elcoco/eeg/README.md

EEG
===

This project is about creating an EEG device based  
on the ADS1299 chip and a raspberrypi 2.  
In this repository you'll find cad files for making  
the PCB and also the software.  
It is a work in progress and is nowhere near finished.
