elcoco/eeg/docs/7077.BandwidthSlide.pptx

## Signals from Body

- EMG (Electromyography) – electrical activity by skeletal muscles
- ECG (Electrocardiography) – electrical activity of the heart
- EEG (Electroencephalography) – electrical activity of the brain
- Pace signal – Signal from Pacemaker
- Respiration – study of impedance created from inhale/exhale

## Bandwidth of interest

~10mV

EMG Signal

ECG Signal

Including Gamma

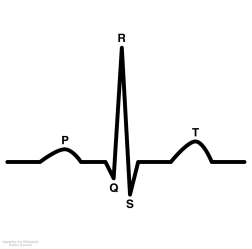
[picture p1: figure]

~5mV

Max Signal Amplitude

~5mV

Pacemaker Signal

~1mV

EEG Signal

Respiration 0 to 0.4Hz

*Amplitude dependent on external current source

20Hz

60Hz

150Hz

500Hz

10 KHz

0.05Hz

50Hz

120Hz

*Frequency ranges are estimates. Actual frequency range will depend on specific application

Frequency
