elcoco/eeg/docs/schematic from blog.png

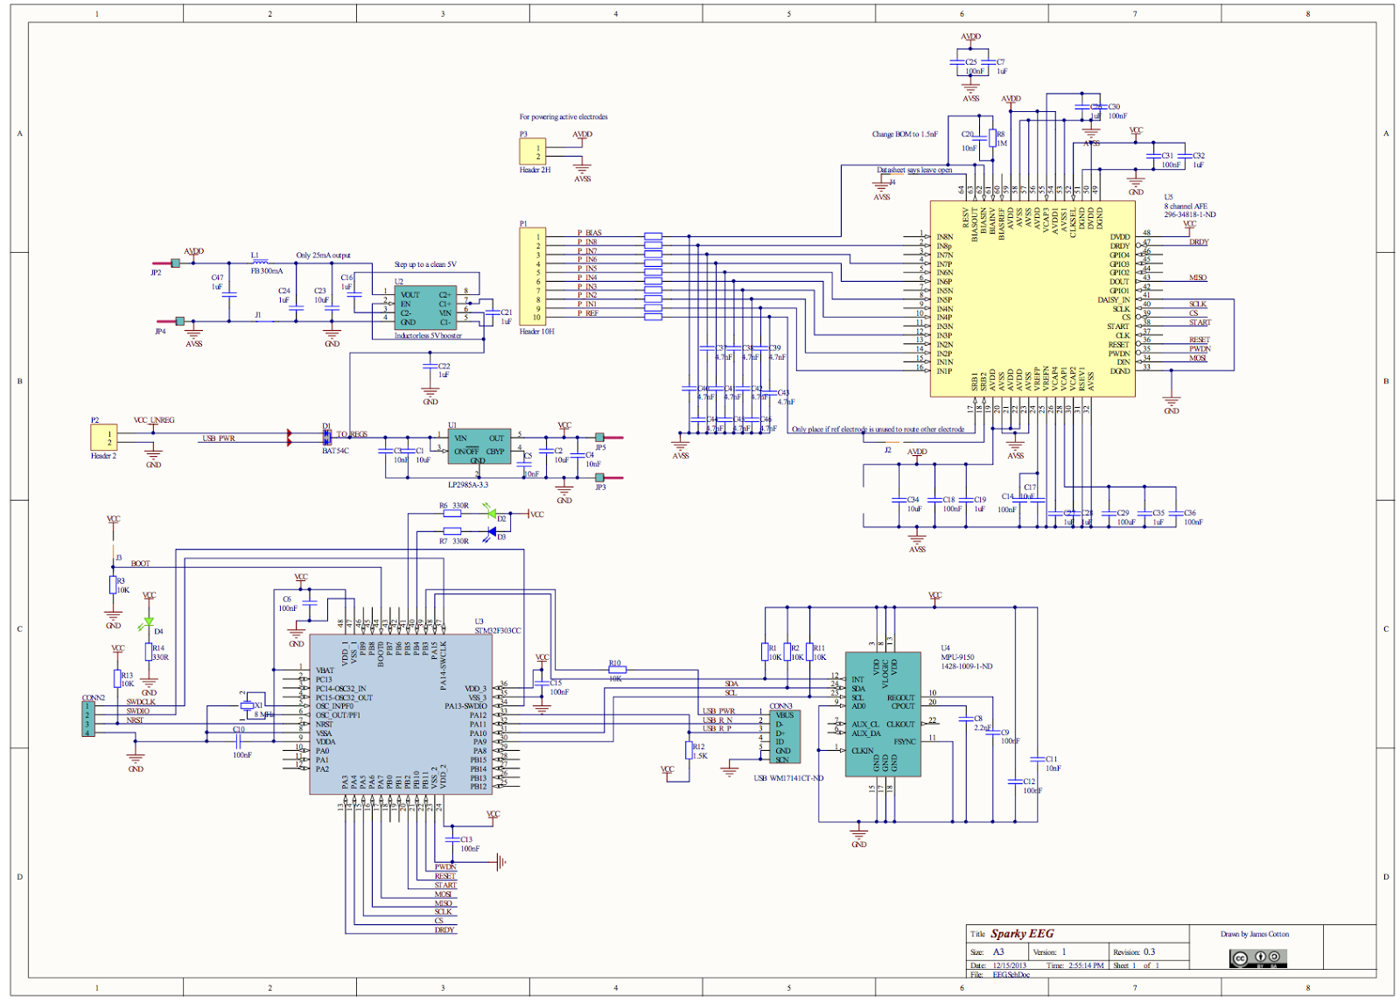
docs/schematic from blog.png
