elcoco/eeg/docs/ADS family comparison.xls

Part Number | Description | Status | # Input Channels | Analog Voltage AV/DD(Min)(V) | Analog Voltage AV/DD(Max)(V) | Architecture | Digital Supply(Max)(V) | Digital Supply(Min)(V) | Gain Drift(Typ)(ppm/degC) | Gain Error(Typ)(%) | IAVDD Supply Current(Typ)(mA) | IDVDD Supply Current(Typ)(mA) | INL(Typ)(ppm) | Input-referred Noise(Typ)(uVpp) | Integrated Features | Interface | Offset Error(Typ)(uV) | Offset error drift(Typ)(uV/C) | PGA Gain(Typ)(V/V) | Power Consumption(Typ)(mW) | Power/Channel(Typ)(mW) | Reference Mode | Rating | Operating Temperature Range(C) | Package Group
ADS1293 (http://www.ti.com/product/ads1293) | Complete Low Power Integrated Analog Front End for ECG Applications | ACTIVE | 3 | 2.7 | 5.5 | Delta-Sigma | 3.6 | 1.65 | 10 | 1.4 | 0.205 | 0.0006 | 2 | 7 | Oscillator | Serial SPI | 16 | 0.01 | 3.5 | 0.9 | 0.3 | Int | Catalog | -20 to 85 | WQFN
ADS1299 (http://www.ti.com/product/ads1299) | Low-Noise, 8-Channel, 24-Bit Analog Front-End for Biopotential Measurements | ACTIVE | 8 | 4.75 | 5.25 | Delta-Sigma | 3.6 | 1.8 |  |  |  |  |  | 1 | Daisy-Chainable, GPIOs, Oscillator, PGA | Serial SPI |  |  | 1, 2, 4, 6, 8, 12, 24 | 41 | 5.125 | Int, Ext | Catalog | -40 to 85 | TQFP
ADS1292R (http://www.ti.com/product/ads1292r) | 3-Channel, 24-Bit Analog-To-Digital Converter w/Integrated Respiration Impedance and ECG Front End | ACTIVE | 3 | 2.7 | 5.25 | Delta-Sigma | 3.6 | 1.7 |  |  |  |  | 2 | 8 | Daisy-Chainable, GPIOs, Oscillator, PGA | Serial SPI |  |  | 1, 2, 3, 4, 6, 8, 12 | 0.7 | 0.35 | Int, Ext | Catalog | -40 to 85 | TQFP, VQFN
ADS1191 (http://www.ti.com/product/ads1191) | Complete Low Power Integrated Analog Front End for ECG Applications | ACTIVE | 1 | 2.7 | 5.25 | Delta-Sigma | 3.6 | 1.7 |  |  |  |  | 15 | 24 | Daisy-Chainable, GPIOs, Oscillator, PGA | Serial SPI |  |  | 1, 2, 3, 4, 6, 8, 12 | 0.335 | 0.335 | Int, Ext | Catalog | -40 to 85 | TQFP, VQFN
ADS1192 (http://www.ti.com/product/ads1192) | Complete Low Power Integrated Analog Front End for ECG Applications | ACTIVE | 2 | 2.7 | 5.25 | Delta-Sigma | 3.6 | 1.7 |  |  |  |  | 15 | 24 | Daisy-Chainable, GPIOs, Oscillator, PGA | Serial SPI |  |  | 1, 2, 3, 4, 6, 8, 12 | 0.67 | 0.335 | Int, Ext | Catalog | -40 to 85 | TQFP, VQFN
ADS1291 (http://www.ti.com/product/ads1291) | Complete Low Power Integrated Analog Front End for ECG Applications | ACTIVE | 1 | 2.7 | 5.25 | Delta-Sigma | 3.6 | 1.7 |  |  |  |  | 2 | 8 | Daisy-Chainable, GPIOs, Oscillator, PGA | Serial SPI |  |  | 1, 2, 3, 4, 6, 8, 12 | 0.35 | 0.35 | Int, Ext | Catalog | -40 to 85 | TQFP, VQFN
ADS1292 (http://www.ti.com/product/ads1292) | Complete Low Power Integrated Analog Front End for ECG Applications | ACTIVE | 3 | 2.7 | 5.25 | Delta-Sigma | 3.6 | 1.7 |  |  |  |  | 2 | 8 | Daisy-Chainable, GPIOs, Oscillator, PGA | Serial SPI |  |  | 1, 2, 3, 4, 6, 8, 12 | 0.7 | 0.35 | Int, Ext | Catalog | -40 to 85 | TQFP, VQFN
ADS1294R (http://www.ti.com/product/ads1294r) | 4-Channel, 24-Bit Analog-To-Digital Converter w/Integrated Respiration Impedance and ECG Front End | ACTIVE | 4 | 2.7 | 5.25 | Delta-Sigma | 3.6 | 1.65 | 5 | 0.2 | 2.75 | 0.5 | 8 | 3 | Daisy-Chainable, GPIOs, Oscillator, PGA | Serial SPI | 500 | 5 | 1, 2, 3, 4, 6, 8, 12 | 4.1 | 1.025 | Int, Ext | Catalog | -40 to 85 | NFBGA
ADS1296R (http://www.ti.com/product/ads1296r) | 6-Channel, 24-Bit Analog-To-Digital Converter w/Integrated Respiration Impedance and ECG Front End | ACTIVE | 6 | 2.7 | 5.25 | Delta-Sigma | 3.6 | 1.65 | 5 | 0.2 | 2.75 | 0.5 | 8 | 3 | Daisy-Chainable, GPIOs, Oscillator, PGA | Serial SPI | 500 | 2 | 1, 2, 3, 4, 6, 8, 12 | 5.3 | 0.88 | Int, Ext | Catalog | -40 to 85 | NFBGA
ADS1298R (http://www.ti.com/product/ads1298r) | 8-Channel, 24-Bit Analog-To-Digital Converter w/Integrated Respiration Impedance and ECG Front End | ACTIVE | 8 | 2.7 | 5.25 | Delta-Sigma | 3.6 | 1.65 | 5 | 0.2 | 2.75 | 0.5 | 8 | 3 | Daisy-Chainable, GPIOs, Oscillator, PGA | Serial SPI | 500 | 2 | 1, 2, 3, 4, 6, 8, 12 | 6 | 0.75 | Int, Ext | Catalog | -40 to 85 | NFBGA
ADS1194 (http://www.ti.com/product/ads1194) | Low-Power, 4-Channel, 16-Bit Analog Front-End for ECG | ACTIVE | 4 | 2.7 | 5.25 | Delta-Sigma | 3.6 | 1.65 | 5 | 0.2 | 0.5 | 0.5 | 15 | 12.2 | Daisy-Chainable, GPIOs, Oscillator, PGA | Serial SPI | 500 | 2 | 1, 2, 3, 4, 6, 8, 12 | 3 | 0.75 | Int, Ext | Catalog | 0 to 70 | NFBGA, TQFP
ADS1196 (http://www.ti.com/product/ads1196) | Low-Power, 6-Channel, 16-Bit Analog Front-End for ECG | ACTIVE | 6 | 2.7 | 5.25 | Delta-Sigma | 3.6 | 1.65 | 5 | 0.2 | 0.7 | 0.5 | 15 | 12.2 | Daisy-Chainable, GPIOs, Oscillator, PGA | Serial SPI | 500 | 2 | 1, 2, 3, 4, 6, 8, 12 | 3.6 | 0.6 | Int, Ext | Catalog | 0 to 70 | NFBGA, TQFP
ADS1294 (http://www.ti.com/product/ads1294) | 4-Channel, 24-Bit Analog-To-Digital Converter With Integrated ECG Front End | ACTIVE | 4 | 2.7 | 5.25 | Delta-Sigma | 3.6 | 1.65 | 5 | 0.2 | 2.75 | 0.5 | 8 | 3 | Daisy-Chainable, GPIOs, Oscillator, PGA | Serial SPI | 500 | 2 | 1, 2, 3, 4, 6, 8, 12 | 3 | 0.75 | Int, Ext | Catalog | -40 to 85, 0 to 70 | NFBGA, TQFP
ADS1296 (http://www.ti.com/product/ads1296) | 6-Channel, 24-Bit Analog-To-Digital Converter With Integrated ECG Front End | ACTIVE | 6 | 2.7 | 5.25 | Delta-Sigma | 3.6 | 1.65 | 5 | 0.2 | 2.75 | 0.5 | 8 | 3 | Daisy-Chainable, GPIOs, Oscillator, PGA | Serial SPI | 500 | 2 | 1, 2, 3, 4, 6, 8, 12 | 5.3 | 0.88 | Int, Ext | Catalog | -40 to 85, 0 to 70 | NFBGA, TQFP
ADS1198 (http://www.ti.com/product/ads1198) | Low-Noise, 8 Channel, 16 Bit Analog Front End for ECG/EEG Measurements | ACTIVE | 8 | 2.7 | 5.25 | Delta-Sigma | 3.6 | 1.65 | 5 | 0.2 | 1.3 | 0.5 | 15 | 12.2 | Daisy-Chainable, GPIOs, Oscillator, PGA | Serial SPI | 500 | 2 | 1, 2, 3, 4, 6, 8, 12 | 4.3 | 0.54 | Int, Ext | Catalog | 0 to 70 | NFBGA, TQFP
ADS1298 (http://www.ti.com/product/ads1298) | 8-Channel, 24-Bit Analog-To-Digital Converter With Integrated ECG Front End | ACTIVE | 8 | 2.7 | 5.25 | Delta-Sigma | 3.6 | 1.65 | 5 | 0.2 | 2.75 | 0.5 | 8 | 3 | Daisy-Chainable, GPIOs, Oscillator, PGA | Serial SPI | 500 | 2 | 1, 2, 3, 4, 6, 8, 12 | 6 | 0.75 | Int, Ext | Catalog | -40 to 85, 0 to 70 | NFBGA, TQFP
