elcoco/eeg/(list of files, drawings)

Other design files:
docs/eeg_main_board.fzz
docs/OpenBCI 8bit.pcb
docs/OpenBCI 32bit.pcb
