elcoco/eeg/pcb/kicad/eeg-pcb.kicad_pcb

## KiCad design pcb/kicad/eeg-pcb.kicad_pcb (2016-02-10)

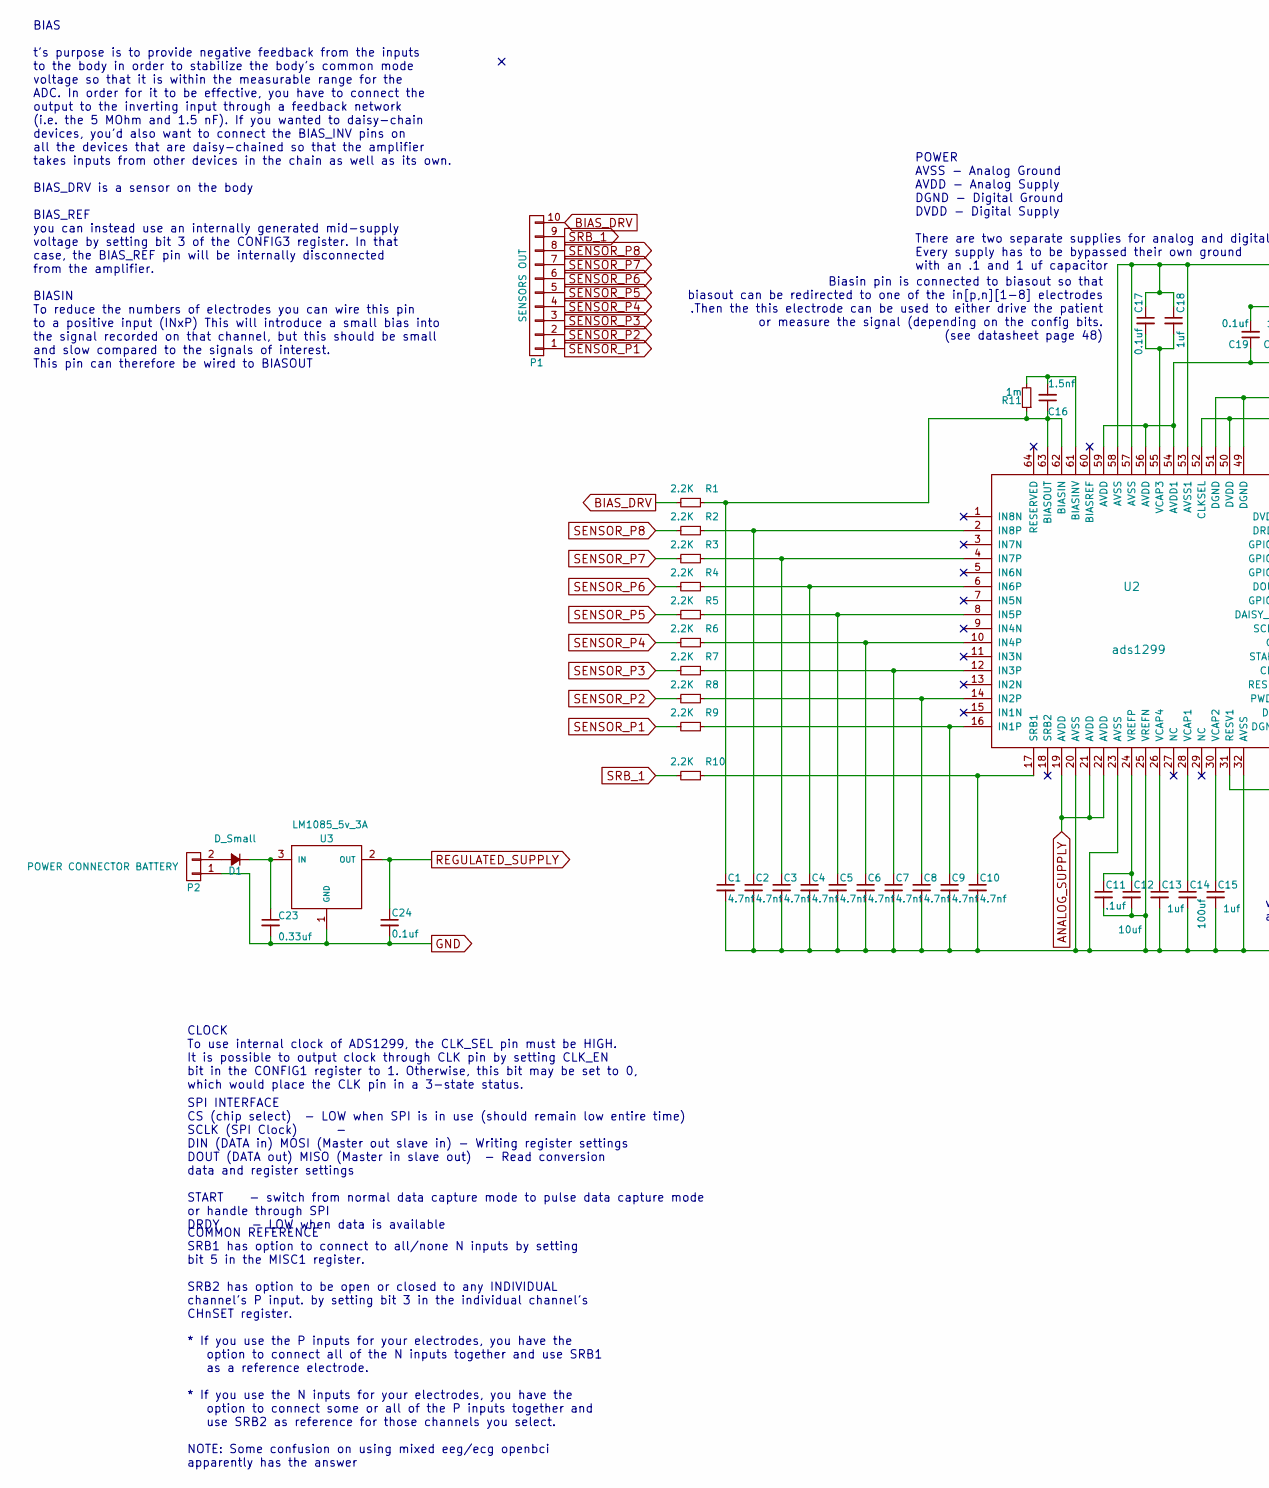
[picture p3: schematic eeg-pcb.sch, EEG Schema using ads1299, part in row 1, column 1]

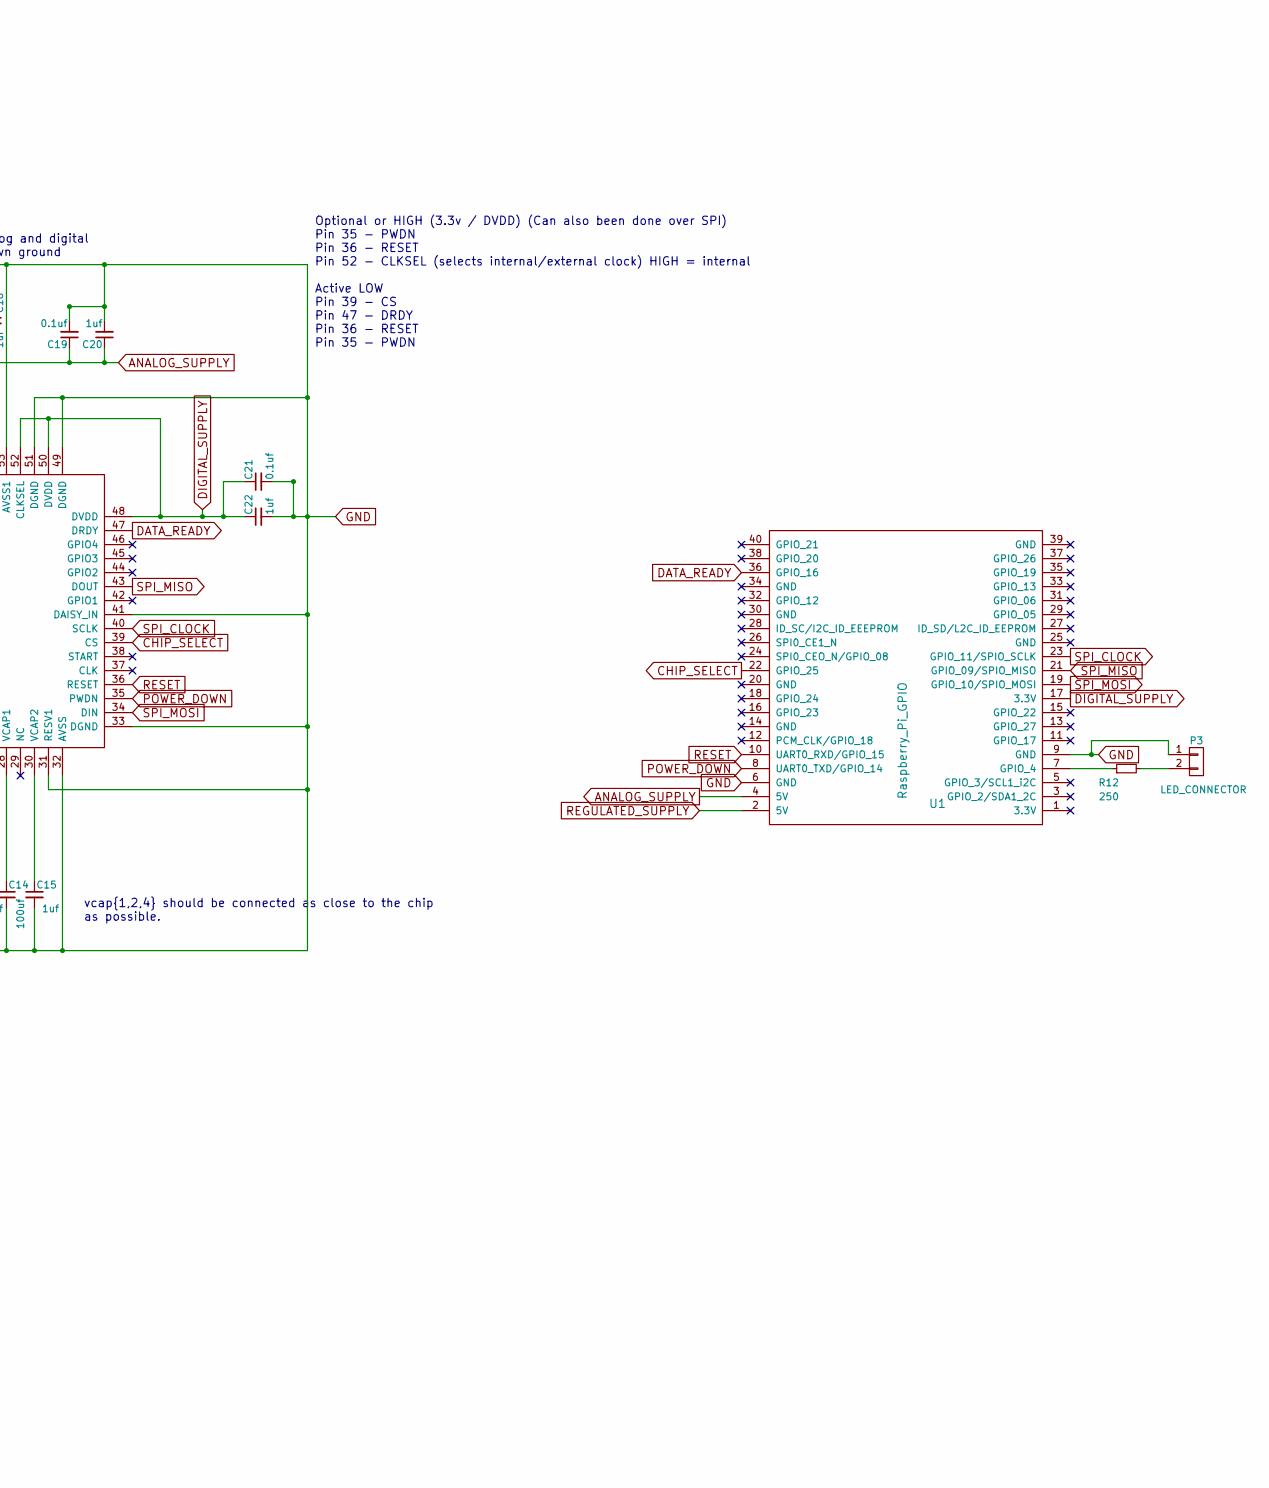
[picture p4: schematic eeg-pcb.sch, EEG Schema using ads1299, part in row 1, column 2]

Parts:
C1, C2, C3, C4, C5, C6, C7, C8, C9, C10: 4.7nf; C_0603_HandSoldering
C11: .1uf; C_0603_HandSoldering
C12: 10uf; C_0603_HandSoldering
C13, C15, C18, C20, C22: 1uf; C_0603_HandSoldering
C14: 100uf; C_0603_HandSoldering
C16: 1.5nf; C_0603_HandSoldering
C17, C19, C21, C24: 0.1uf; C_0603_HandSoldering
C23: 0.33uf; C_0603_HandSoldering
D1: D_Small; 1n1008
P1: SENSORS OUT; Pin_Header_Straight_1x10
P2: POWER CONNECTOR BATTERY; Pin_Header_Straight_1x02
P3: LED_CONNECTOR; Pin_Header_Straight_1x02
R1, R2, R3, R4, R5, R6, R7, R8, R9, R10: 2.2K; R_0603_HandSoldering
R11: 1m; R_0603_HandSoldering
R12: 250; R_0603_HandSoldering
U1: Raspberry_Pi_GPIO; Pin_Header_Straight_2x20
U2: ads1299
U3: LM1085_5v_3A; LM1085

Connections:
ANALOG_SUPPLY: C19.1, C20.1, U1.4 (5V), U2.19 (AVDD), U2.21 (AVDD), U2.22 (AVDD), U2.54 (AVDD1), U2.56 (AVDD), U2.59 (AVDD)
BIAS_DRV: P1.10, R1.2
CHIP_SELECT: U1.22 (GPIO_25), U2.39 (CS)
DATA_READY: U1.36 (GPIO_16), U2.47 (DRDY)
DIGITAL_SUPPLY: C21.1, C22.1, U1.17 (3.3V), U2.48 (DVDD), U2.50 (DVDD), U2.52 (CLKSEL)
GND: C1.2, C2.2, C3.2, C4.2, C5.2, C6.2, C7.2, C8.2, C9.2, C10.2, C11.2, C12.2, C13.2, C14.2, C15.2, C17.1, C18.1, C19.2, C20.2, C21.2, C22.2, C23.2, C24.2, P2.1, P3.1, U1.6 (GND), U1.9 (GND), U2.20 (AVSS), U2.23 (AVSS), U2.25 (VREFN), U2.31 (RESV1), U2.32 (AVSS), U2.33 (DGND), U2.41 (DAISY_IN), U2.49 (DGND), U2.51 (DGND), U2.53 (AVSS1), U2.57 (AVSS), U2.58 (AVSS), U3.1 (GND)
unnamed: C1.1, C16.1, R1.1, R11.1, U2.62 (BIASIN), U2.63 (BIASOUT)
unnamed: C2.1, R2.1, U2.2 (IN8P)
unnamed: C3.1, R3.1, U2.4 (IN7P)
unnamed: C4.1, R4.1, U2.6 (IN6P)
unnamed: C5.1, R5.1, U2.8 (IN5P)
unnamed: C6.1, R6.1, U2.10 (IN4P)
unnamed: C7.1, R7.1, U2.12 (IN3P)
unnamed: C8.1, R8.1, U2.14 (IN2P)
unnamed: C9.1, R9.1, U2.16 (IN1P)
unnamed: C10.1, R10.1, U2.17 (SRB1)
unnamed: C11.1, C12.1, U2.24 (VREFP)
unnamed: C13.1, U2.26 (VCAP4)
unnamed: C14.1, U2.28 (VCAP1)
unnamed: C15.1, U2.30 (VCAP2)
unnamed: C16.2, R11.2, U2.61 (BIASINV)
unnamed: C17.2, C18.2, U2.55 (VCAP3)
unnamed: C23.1, D1.1 (K), U3.3 (IN)
unnamed: D1.2 (A), P2.2
unnamed: P3.2, R12.2
unnamed: R12.1, U1.7 (GPIO_4)
POWER_DOWN: U1.8 (UART0_TXD/GPIO_14), U2.35 (PWDN)
REGULATED_SUPPLY: C24.1, U1.2 (5V), U3.2 (OUT)
RESET: U1.10 (UART0_RXD/GPIO_15), U2.36 (RESET)
SENSOR_P1: P1.1, R9.2
SENSOR_P2: P1.2, R8.2
SENSOR_P3: P1.3, R7.2
SENSOR_P4: P1.4, R6.2
SENSOR_P5: P1.5, R5.2
SENSOR_P6: P1.6, R4.2
SENSOR_P7: P1.7, R3.2
SENSOR_P8: P1.8, R2.2
SPI_CLOCK: U1.23 (GPIO_11/SPIO_SCLK), U2.40 (SCLK)
SPI_MISO: U1.21 (GPIO_09/SPIO_MISO), U2.43 (DOUT)
SPI_MOSI: U1.19 (GPIO_10/SPIO_MOSI), U2.34 (DIN)
SRB_1: P1.9, R10.2

Notes on the sheet:
Optional or HIGH (3.3v / DVDD) (Can also been done over SPI) Pin 35 - PWDN Pin 36 - RESET Pin 52 - CLKSEL (selects internal/external clock) HIGH = internal Active LOW Pin 39 - CS Pin 47 - DRDY Pin 36 - RESET Pin 35 - PWDN
BIAS t's purpose is to provide negative feedback from the inputs to the body in order to stabilize the body's common mode voltage so that it is within the measurable range for the ADC. In order for it to be effective, you have to connect the output to the inverting input through a feedback network 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
COMMON REFERENCE SRB1 has option to connect to all/none N inputs by setting bit 5 in the MISC1 register. SRB2 has option to be open or closed to any INDIVIDUAL channel's P input. by setting bit 3 in the individual channel's CHnSET register. * If you use the P inputs for your electrodes, you have th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
SPI INTERFACE CS (chip select) - LOW when SPI is in use (should remain low entire time) SCLK (SPI Clock) - DIN (DATA in) MOSI (Master out slave in) - Writing register settings DOUT (DATA out) MISO (Master in slave out) - Read conversion data and register settings START - switch from normal data cap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
POWER AVSS - Analog Ground AVDD - Analog Supply DGND - Digital Ground DVDD - Digital Supply There are two separate supplies for analog and digital Every supply has to be bypassed their own ground with an .1 and 1 uf capacitor
CLOCK To use internal clock of ADS1299, the CLK_SEL pin must be HIGH. It is possible to output clock through CLK pin by setting CLK_EN bit in the CONFIG1 register to 1. Otherwise, this bit may be set to 0, which would place the CLK pin in a 3-state status.
vcap{1,2,4} should be connected as close to the chip as possible.
Biasin pin is connected to biasout so that biasout can be redirected to one of the in[p,n][1-8] electrodes .Then the this electrode can be used to either drive the patient or measure the signal (depending on the config bits. (see datasheet page 48)

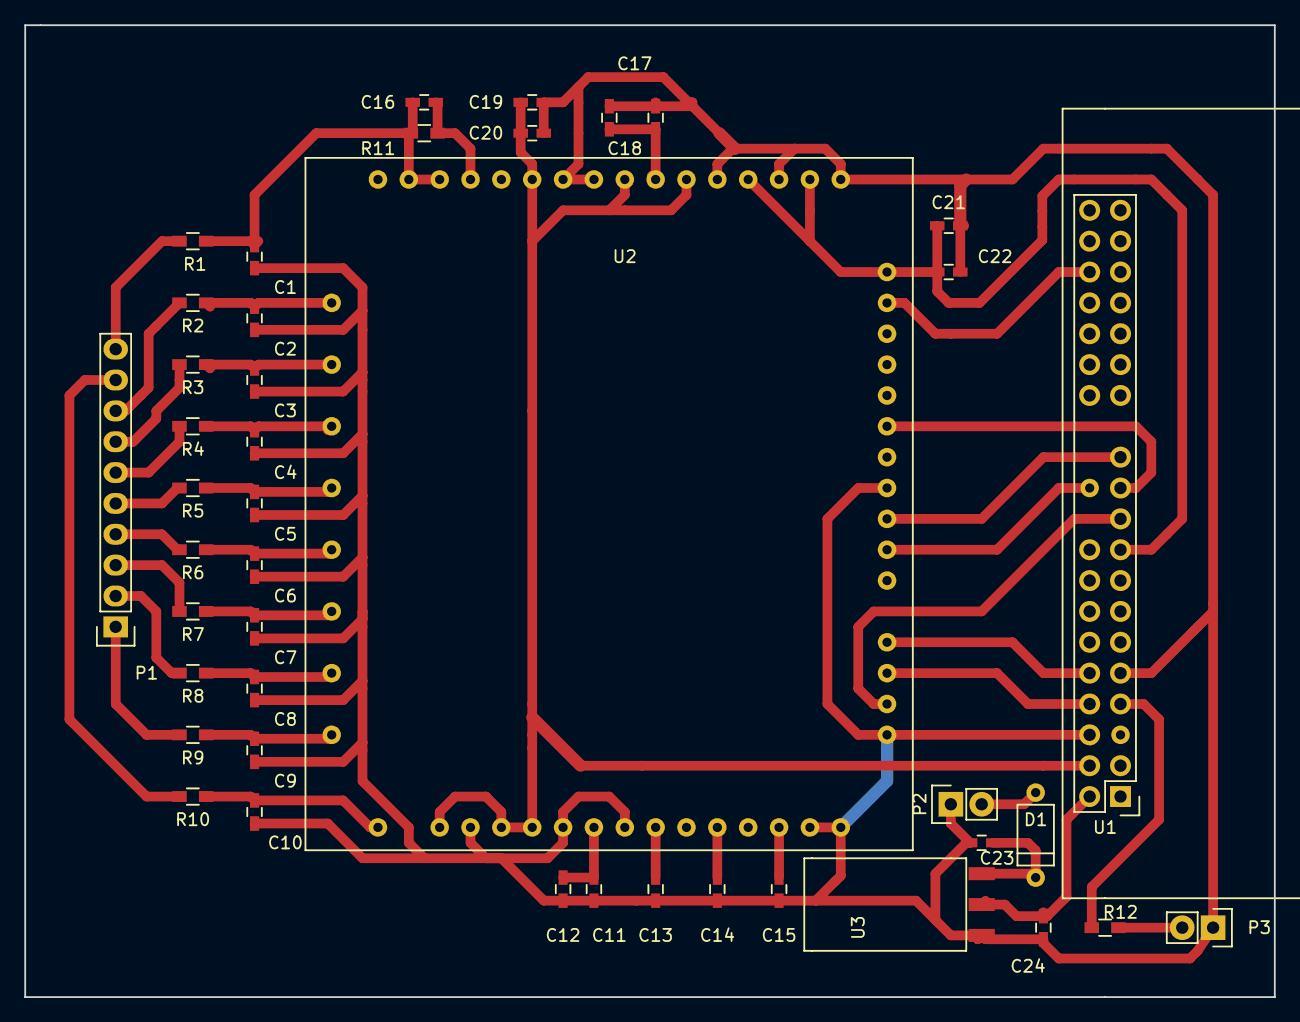
[picture p5: board eeg-pcb.kicad_pcb from above]

Board: 2 copper layers, 102.9 x 80.0 mm, 43 parts (0 on the bottom side), 41 nets.
